LudoVdd/projetelec/(list of files, drawings)

Other design files:
groupe11.pdsprj
