LudoVdd/projetelec/groupe11finis2.brd

## EAGLE design groupe11finis2.brd (2019-05-20)

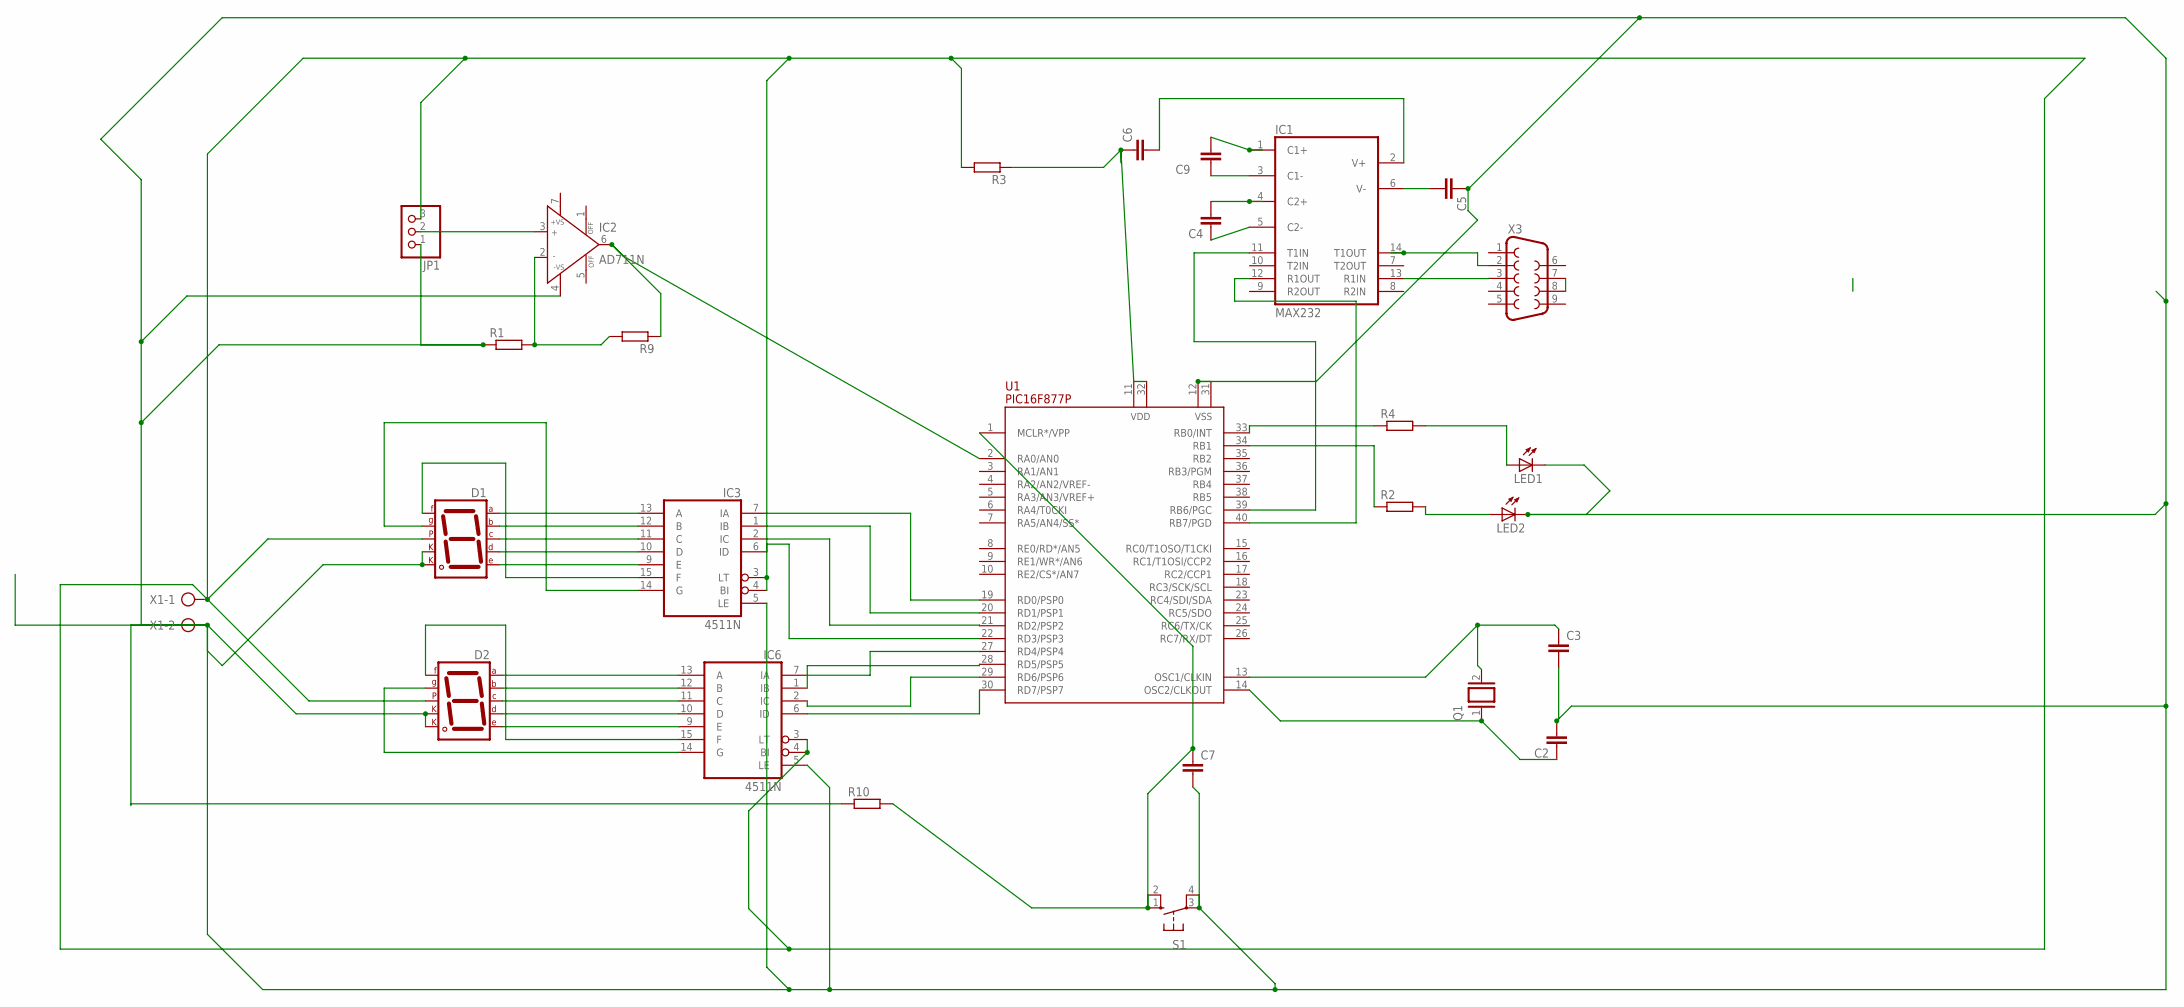
[picture p5: schematic groupe11finis2.sch]

Parts:
C2, C3, C4, C5, C6, C7, C9: C-EU025-024X044; C025-024X044
D1, D2: 7SEG-CK; 7SEG-13
IC1: MAX232; DIL16
IC2: AD711N; DIL08
IC3, IC6: 4511N; DIL16
JP1: PINHD-1X3; 1X03
LED1, LED2: LED_ELD260; LED_LD260
Q1: XTAL/S; QS
R1, R2, R3, R4, R9, R10: R-EU_0207/10; 0207/10
S1: 10-XX; B3F-10XX
U1: PIC16F877P; DIL40
X1: AK300/2
X3: F09V

Connections:
GND: IC1.15 (GND)
unnamed: IC1.13 (R1IN), X3.3
unnamed: C9.2, IC1.1 (C1+)
unnamed: IC1.14 (T1OUT), X3.2
unnamed: C9.1, IC1.3 (C1-)
unnamed: IC1.11 (T1IN), U1.39 (RB6/PGC)
unnamed: C4.2, IC1.4 (C2+)
unnamed: IC1.12 (R1OUT), U1.40 (RB7/PGD)
unnamed: C4.1, IC1.5 (C2-)
unnamed: C6.2, IC1.2 (V+)
unnamed: C5.2, IC1.6 (V-)
unnamed: IC3.7 (IA), U1.19 (RD0/PSP0)
unnamed: IC3.1 (IB), U1.20 (RD1/PSP1)
unnamed: IC3.2 (IC), U1.21 (RD2/PSP2)
unnamed: IC3.6 (ID), U1.22 (RD3/PSP3)
unnamed: IC6.7 (IA), U1.27 (RD4/PSP4)
unnamed: IC6.1 (IB), U1.28 (RD5/PSP5)
unnamed: IC6.2 (IC), U1.29 (RD6/PSP6)
unnamed: IC6.6 (ID), U1.30 (RD7/PSP7)
unnamed: D1.7 (A), IC3.13 (A)
unnamed: D1.6 (B), IC3.12 (B)
unnamed: D1.4 (C), IC3.11 (C)
unnamed: D1.2 (D), IC3.10 (D)
unnamed: D1.1 (E), IC3.9 (E)
unnamed: D1.9 (F), IC3.15 (F)
unnamed: D1.10 (G), IC3.14 (G)
unnamed: D2.7 (A), IC6.13 (A)
unnamed: LED2.A, R2.2
unnamed: D2.6 (B), IC6.12 (B)
unnamed: R2.1, U1.34 (RB1)
unnamed: D2.2 (D), IC6.10 (D)
unnamed: D2.1 (E), IC6.9 (E)
unnamed: D2.9 (F), IC6.15 (F)
unnamed: D2.10 (G), IC6.14 (G)
unnamed: R4.1, U1.33 (RB0/INT)
unnamed: IC2.3 (IN+), JP1.2
unnamed: LED1.A, R4.2
unnamed: IC2.2 (IN-), R1.2, R9.2
unnamed: C3.1, Q1.2, U1.13 (OSC1/CLKIN)
unnamed: C7.1, R10.2, S1.1 (S), S1.2 (S1), U1.1 (MCLR*/VPP)
unnamed: C2.1, Q1.1, U1.14 (OSC2/CLKOUT)
unnamed: X3.7, X3.8
unnamed: IC2.6 (OUT), R9.1, U1.2 (RA0/AN0)
unnamed: C6.1, R3.1, U1.11 (VDD), U1.32 (VDD)
unnamed: D2.4 (C), IC6.11 (C)
unnamed: D1.5 (DP), D2.5 (DP), IC3.3 (LT), IC3.4 (BI), IC6.3 (LT), IC6.4 (BI), JP1.3, R3.2, X1.1
unnamed: C2.2, C3.2, C5.1, C7.2, D1.3 (CK1), D1.8 (CK2), D2.3 (CK1), D2.8 (CK2), IC2.4 (-VS), IC3.5 (LE), IC6.5 (LE), JP1.1, LED1.K (C), LED2.K (C), R1.1, R10.1, S1.3, S1.4 (P1), U1.12 (VSS), U1.31 (VSS), X1.2
VCC: IC1.16 (VCC)
VDD: IC3.16 (VDD), IC6.16 (VDD)
VSS: IC3.8 (VSS), IC6.8 (VSS)

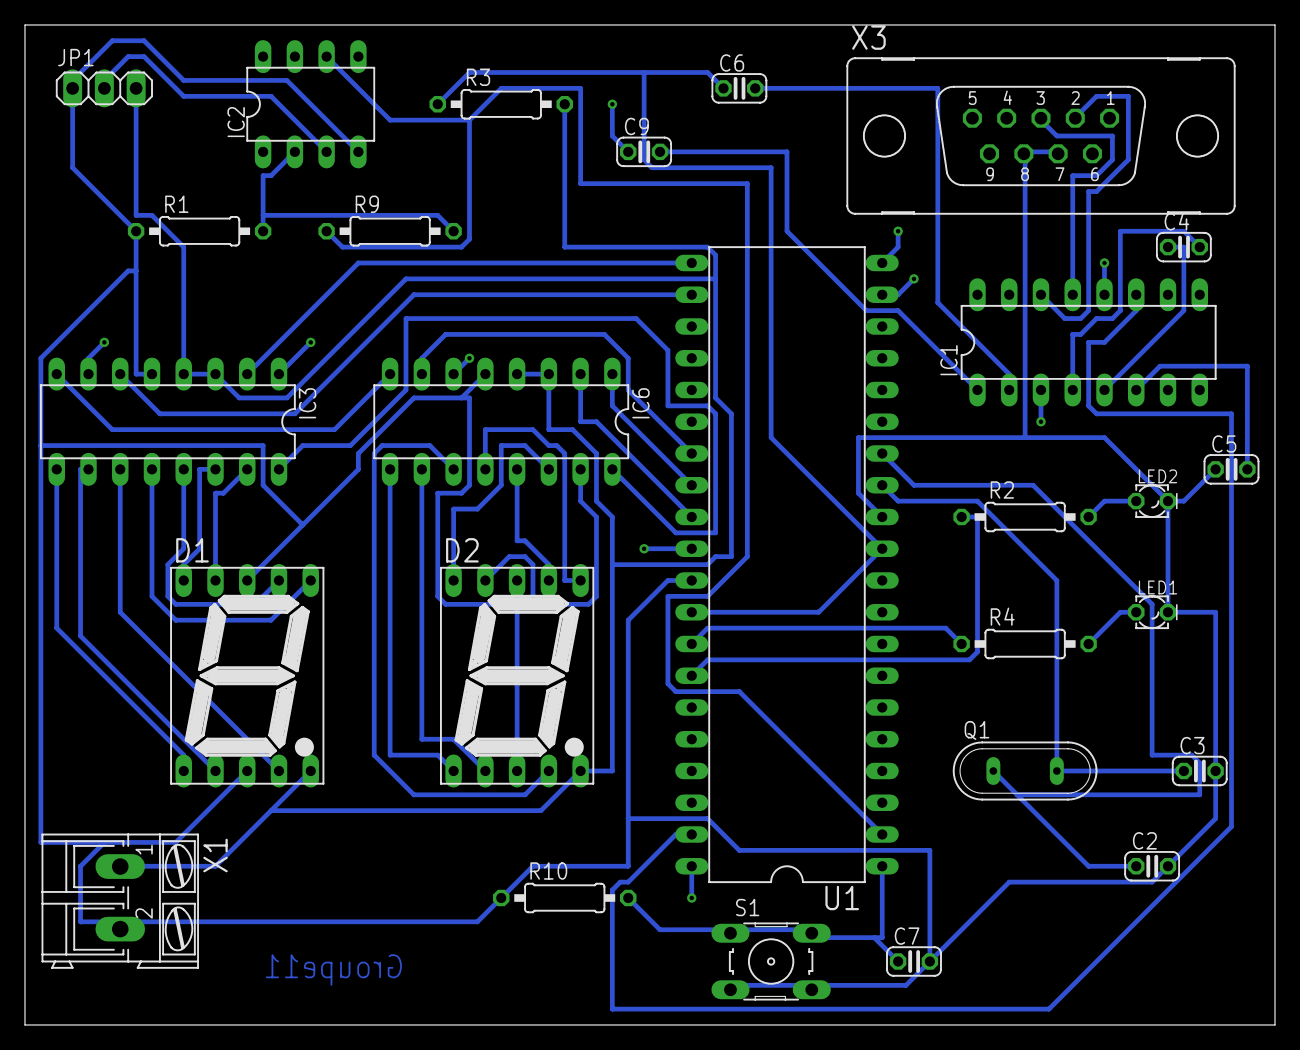
[picture p6: board groupe11finis2.brd from above]

Board: 2 copper layers, 100.0 x 80.0 mm, 27 parts (0 on the bottom side), 48 nets.
